caketetu/SPM-STMTB-SLED/SPM-STMTB-V1_SLED-Shield.kicad_pcb

## KiCad design SPM-STMTB-V1_SLED-Shield.kicad_pcb (2026-10-27)

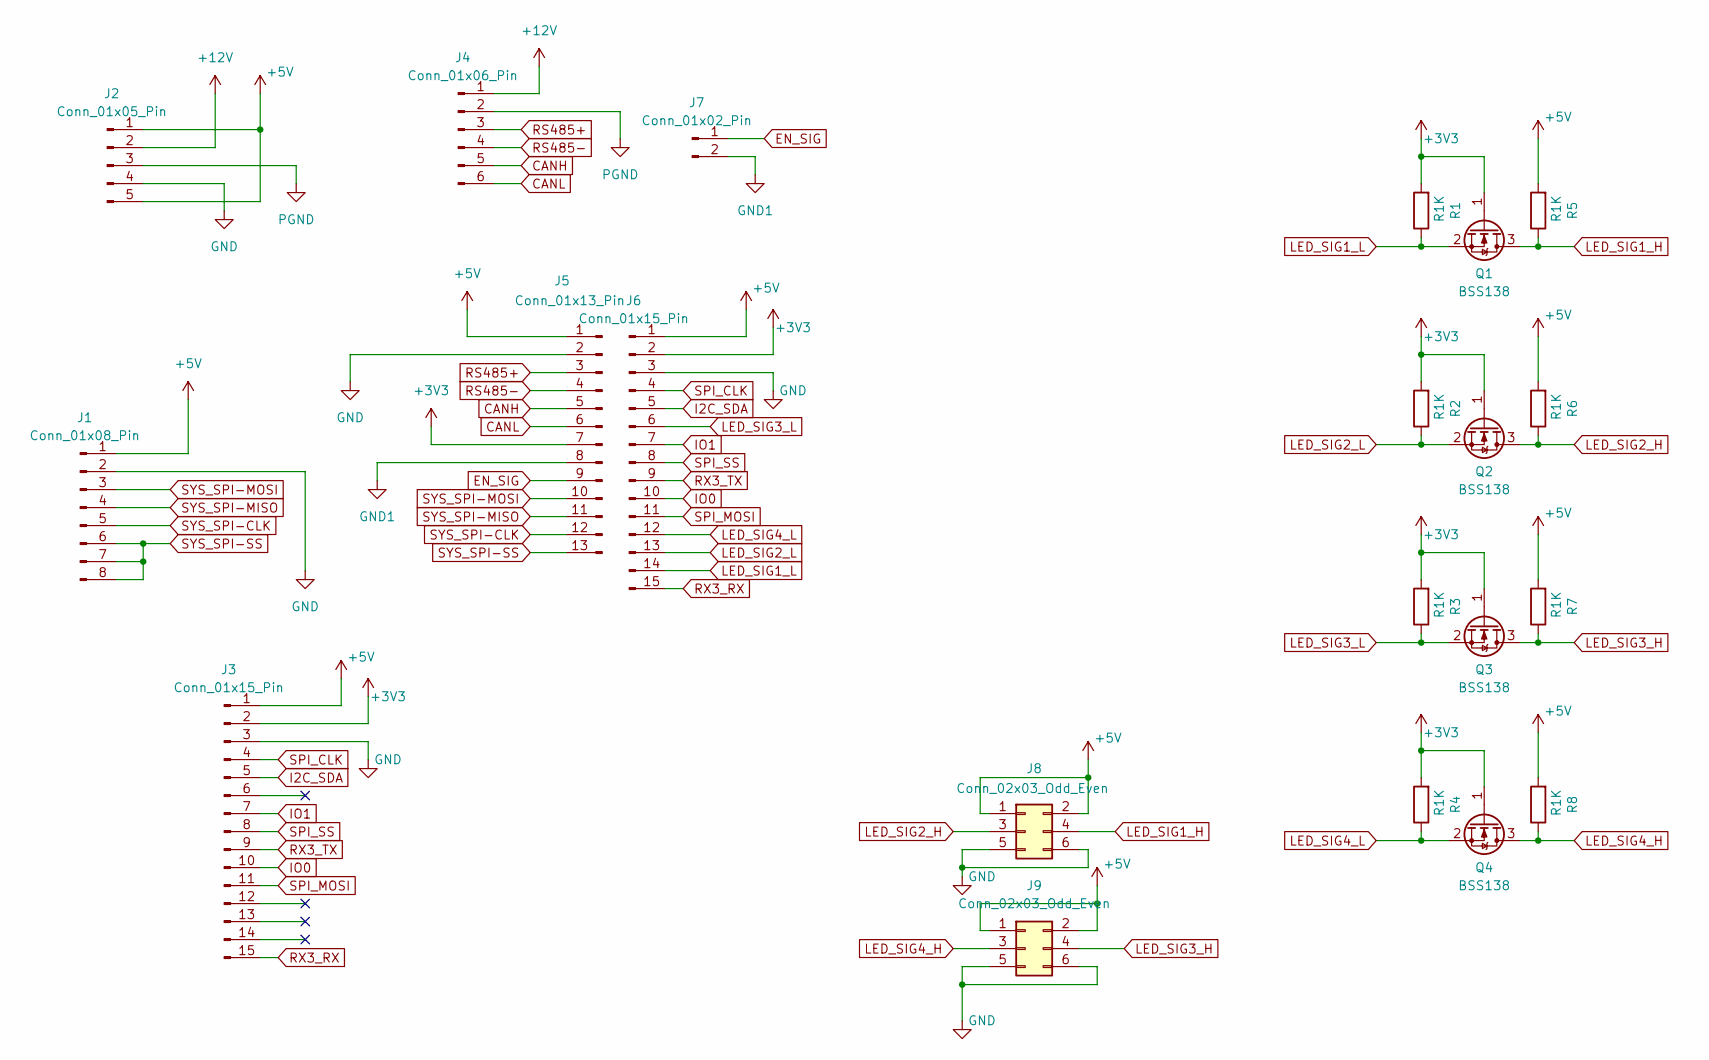
[picture p1: schematic SPM-STMTB-V1_SLED-Shield.kicad_sch]

Parts:
J1: Conn_01x08_Pin; PinSocket_1x08_P2.54mm_Vertical
J2: Conn_01x05_Pin; PinSocket_1x05_P2.54mm_Vertical
J3, J6: Conn_01x15_Pin; PinSocket_1x15_P2.54mm_Vertical
J4: Conn_01x06_Pin; PinHeader_1x06_P2.54mm_Vertical
J5: Conn_01x13_Pin; PinSocket_1x13_P2.54mm_Vertical
J7: Conn_01x02_Pin; PinSocket_1x02_P2.54mm_Vertical
J8, J9: Conn_02x03_Odd_Even; PinHeader_2x03_P2.54mm_Horizontal
Q1, Q2, Q3, Q4: BSS138; SOT-23
R1, R2, R3, R4, R5, R6, R7, R8: R1K; R_0603_1608Metric

Connections:
+3V3: J3.2, J5.7, J6.2, Q1.1 (G), Q2.1 (G), Q3.1 (G), Q4.1 (G), R1.2, R2.2, R3.2, R4.2
+5V: J1.1, J2.1, J2.5, J3.1, J5.1, J6.1, J8.1, J8.2, J9.1, J9.2, R5.2, R6.2, R7.2, R8.2
+12V: J2.2, J4.1
CANH: J4.5, J5.5
CANL: J4.6, J5.6
EN_SIG: J5.9, J7.1
GND: J1.2, J2.4, J3.3, J5.2, J6.3, J8.5, J8.6, J9.5, J9.6
GND1: J5.8, J7.2
I2C_SDA: J3.5, J6.5
IO0: J3.10, J6.10
IO1: J3.7, J6.7
LED_SIG1_H: J8.4, Q1.3 (D), R5.1
LED_SIG1_L: J6.14, Q1.2 (S), R1.1
LED_SIG2_H: J8.3, Q2.3 (D), R6.1
LED_SIG2_L: J6.13, Q2.2 (S), R2.1
LED_SIG3_H: J9.4, Q3.3 (D), R7.1
LED_SIG3_L: J6.6, Q3.2 (S), R3.1
LED_SIG4_H: J9.3, Q4.3 (D), R8.1
LED_SIG4_L: J6.12, Q4.2 (S), R4.1
PGND: J2.3, J4.2
RS485+: J4.3, J5.3
RS485-: J4.4, J5.4
RX3_RX: J3.15, J6.15
RX3_TX: J3.9, J6.9
SPI_CLK: J3.4, J6.4
SPI_MOSI: J3.11, J6.11
SPI_SS: J3.8, J6.8
SYS_SPI-CLK: J1.5, J5.12
SYS_SPI-MISO: J1.4, J5.11
SYS_SPI-MOSI: J1.3, J5.10
SYS_SPI-SS: J1.6, J1.7, J1.8, J5.13

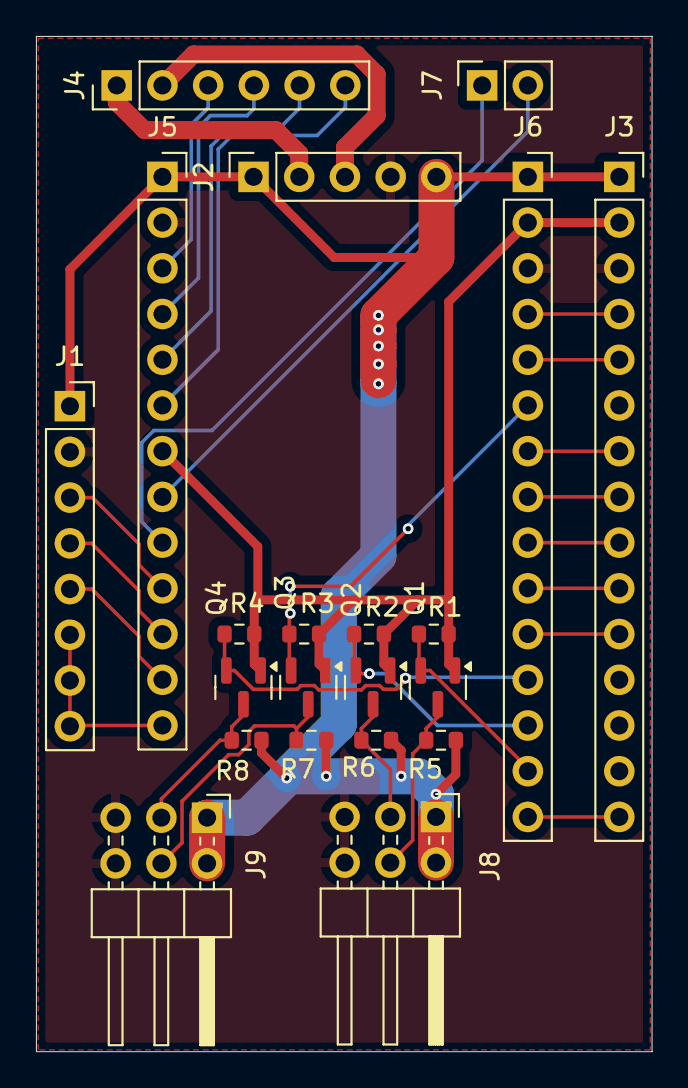
[picture p2: board SPM-STMTB-V1_SLED-Shield.kicad_pcb from above]

Board: 2 copper layers, 34.2 x 56.4 mm, 21 parts (0 on the bottom side), 31 nets.
