caketetu/SPM-STMTB-SLED/Core/Src/SPM_Modbus.c

/*
 * Mymodbus.cpp
 *
 *  Created on: Sep 16, 2025
 *      Author: t-fukumoto
 */

#include "SPM_Modbus.h"

#ifdef PLATFORM_ESP32
	String params = "/params.txt";
#endif
uint8_t p_data[HOLDING_REGS_MAX*2];

uint8_t modbus_id;
int16_t *p_input_regs[INPUT_REGS_MAX];
uint8_t *p_coils[COILS_MAX/8];
int16_t *p_holding_regs[HOLDING_REGS_MAX];
sCycFunc cycfunc0;
sCycFunc cycfunc1;
sCycFunc cycfunc2;
sCycFunc cycfunc3;
sCycFunc cycfunc4;
int16_t dummy16=0;	//ダミーのアドレス16bit
uint8_t dummy8=0;	//ダミーのアドレス8bit

// buf		受信データ
// length	受信データ長(CRCを除く)
uint16_t calc_crc(uint8_t *buf, int length) {
  uint16_t crc = 0xFFFF;
  int i, j;
  uint8_t carrayFlag;
  for (i = 0; i < length; i++) {
    crc ^= buf[i];
    for (j = 0; j < 8; j++) {
      carrayFlag = crc & 1;
      crc = crc >> 1;
      if (carrayFlag) {
        crc ^= 0xA001;
      }
    }
  }
  return crc;
}

uint16_t convert_uint16(uint8_t h_data, uint8_t l_data) {
  uint16_t conv_data = (uint16_t)(h_data << 8) + l_data;
  return conv_data;
}

int16_t convert_int16(uint8_t h_data, uint8_t l_data) {
  int16_t conv_data = (int16_t)(h_data << 8) + l_data;
  return conv_data;
}

//パラメータセーブ
#ifdef PLATFORM_ESP32
int param_save(fs::FS &fs)
{
  fs.remove(params);

  File file = fs.open(params,"w");
  if( file ){
    for(int i=0; i<HOLDING_REGS_MAX*2; i+=2){
      p_data[i] = (uint8_t)(*p_holding_regs[i/2] >> 8);
      p_data[i+1] = *p_holding_regs[i/2];
    }

    file.write((uint8_t*)p_data, sizeof(p_data));
    file.close();
    return 1;
  }
  else{
    return 0;
  }
}

//パラメータロード
int param_load(fs::FS &fs)
{
  File file = fs.open(params,"r"); //データを読み込む

  if(file){ //ファイルを開いて以下を処理
    file.read((uint8_t*)p_data, sizeof(p_data));
    file.close(); //ファイルを閉じる
    Serial.println("param load");
    for(int i=0; i<HOLDING_REGS_MAX*2; i+=2){
      *p_holding_regs[i/2] = convert_int16(p_data[i], p_data[i+1]);
    }
    return 1;
  }
  else{ //ファイルが開けなかった場合
    return 0;
  }
}
#endif

//パラメータセーブ
#ifdef PLATFORM_STM32
uint32_t FlashEraseData(){
	HAL_FLASH_Unlock();
	FLASH_EraseInitTypeDef erase;
	erase.TypeErase=FLASH_TYPEERASE_PAGES;
	erase.PageAddress = 0x800F000;
	erase.NbPages=1;

	uint32_t error=0;
	HAL_FLASHEx_Erase(&erase, &error);

	HAL_FLASH_Lock();
	return error;

}
int ParamSave()
{
	uint32_t start_addr=0x800F000;

	FlashEraseData();
	HAL_FLASH_Unlock();
	for(int i=0; i<HOLDING_REGS_MAX; i++){
		int16_t fdata=*p_holding_regs[i];
		HAL_FLASH_Program(FLASH_TYPEPROGRAM_HALFWORD, start_addr+(i*2),fdata);
	}
	HAL_FLASH_Lock();

	return 1;
}
//パラメータロード
int ParamLoad()
{
	uint32_t* p = 0x800F000;
	uint32_t start_addr=0x800F000;//0x0807F800;

	uint8_t flash_data[HOLDING_REGS_MAX*2];
	memcpy(flash_data,(uint32_t*)start_addr,HOLDING_REGS_MAX*2);

//    for(int i=0; i<HOLDING_REGS_MAX*2; i++){
//    	uint8_t* adr = start_addr+i;
//    	flash_data[i] = *adr;
//    }

    for(int i=0; i<HOLDING_REGS_MAX*2; i+=2){
      *p_holding_regs[i/2] = convert_int16(flash_data[i+1], flash_data[i]);
    }
    return 1;
}
#endif

//パラメータセーブ
#ifdef PLATFORM_STM32C0
#define PARAM_FLASH_ADDR    0x0801F800U
#define FLASH_PAGE_SIZE_C0  0x800U       // 2048 bytes
/*
 * STM32C092KBT6
 * Flash = 128KB
 * Flash start = 0x08000000
 * Last page   = 0x0801F800 ～ 0x0801FFFF
 *
 * 0x0801F800 = page 63
 */
#define PARAM_FLASH_PAGE    63U
//====================================================
// Flash消去
//====================================================
uint32_t FlashEraseData(void)
{
    FLASH_EraseInitTypeDef erase = {0};
    uint32_t page_error = 0;

    if (HAL_FLASH_Unlock() != HAL_OK)
    {
        return 1;
    }

    erase.TypeErase = FLASH_TYPEERASE_PAGES;
    erase.Page      = PARAM_FLASH_PAGE;
    erase.NbPages   = 1;

    HAL_StatusTypeDef status = HAL_FLASHEx_Erase(&erase, &page_error);

    HAL_FLASH_Lock();

    if (status != HAL_OK)
    {
        return page_error;
    }

    return 0;
}

//====================================================
// パラメータ保存
//====================================================
int ParamSave(void)
{
    FlashEraseData();

    HAL_FLASH_Unlock();

    for (uint32_t i = 0; i < HOLDING_REGS_MAX; i += 4)
    {
        uint64_t data =
              ((uint64_t)(uint16_t)(*p_holding_regs[i + 0]))
            | ((uint64_t)(uint16_t)(*p_holding_regs[i + 1]) << 16)
            | ((uint64_t)(uint16_t)(*p_holding_regs[i + 2]) << 32)
            | ((uint64_t)(uint16_t)(*p_holding_regs[i + 3]) << 48);

        HAL_FLASH_Program(
            FLASH_TYPEPROGRAM_DOUBLEWORD,
            PARAM_FLASH_ADDR + (i / 4) * 8,
            data
        );
    }

    HAL_FLASH_Lock();

    return 1;
}

//====================================================
// パラメータロード
//====================================================
int ParamLoad(void)
{
    for (uint32_t i = 0; i < HOLDING_REGS_MAX; i += 4)
    {
        uint64_t data =
            *(volatile uint64_t *)
            (PARAM_FLASH_ADDR + (i / 4) * 8);

        *p_holding_regs[i + 0] = (int16_t)( data        & 0xFFFF);
        *p_holding_regs[i + 1] = (int16_t)((data >> 16) & 0xFFFF);
        *p_holding_regs[i + 2] = (int16_t)((data >> 32) & 0xFFFF);
        *p_holding_regs[i + 3] = (int16_t)((data >> 48) & 0xFFFF);
    }

    return 1;
}
#endif

void make_exception_resp(uint8_t *buf, uint8_t id, uint8_t fc, uint8_t ec) {
  buf[0] = id;
  buf[1] = fc | 0x80;
  buf[2] = ec;
  uint16_t crc = calc_crc(buf, 3);
  buf[4] = crc;
  buf[5] = (uint8_t)(crc >> 8);
  return;
}

void SPM_ModbusInit(void) {
	for(int i=0; i<COILS_MAX/8;i++)
	{
		p_coils[i] = &dummy8;
	}
	for(int i=0; i<INPUT_REGS_MAX;i++)
	{
		p_input_regs[i] = &dummy16;
	}
	for(int i=0; i<HOLDING_REGS_MAX;i++)
	{
		p_holding_regs[i] = &dummy16;
	}

	cycfunc0.rx_len=0;
	cycfunc0.tx_len=0;
	for(int i=0; i<8;i++)
	{
		cycfunc0.rx_adr[i] = &dummy16;
		cycfunc0.tx_adr[i] = &dummy16;
	}

	cycfunc1.rx_len=0;
	cycfunc1.tx_len=0;
	for(int i=0; i<8;i++)
	{
		cycfunc1.rx_adr[i] = &dummy16;
		cycfunc1.tx_adr[i] = &dummy16;
	}

	cycfunc2.rx_len=0;
	cycfunc2.tx_len=0;
	for(int i=0; i<8;i++)
	{
		cycfunc2.rx_adr[i] = &dummy16;
		cycfunc2.tx_adr[i] = &dummy16;
	}

	cycfunc3.rx_len=0;
	cycfunc3.tx_len=0;
	for(int i=0; i<8;i++)
	{
		cycfunc3.rx_adr[i] = &dummy16;
		cycfunc3.tx_adr[i] = &dummy16;
	}

	cycfunc4.rx_len=0;
	cycfunc4.tx_len=0;
	for(int i=0; i<8;i++)
	{
		cycfunc4.rx_adr[i] = &dummy16;
		cycfunc4.tx_adr[i] = &dummy16;
	}
}

void SPM_ModbusSetAddress(uint8_t dev_id) {
	modbus_id = dev_id;
}

/*int SPM_ModbusParamLoad(void) {
#ifdef PLATFORM_ESP32
  if (!SPIFFS.begin(FORMAT_SPIFFS_IF_FAILED)) {
    Serial.println("SPIFFS Mount Failed");
    while(1);
  }
  return param_load(SPIFFS);
#endif
}*/

int SPM_ModbusTask(uint8_t *rbuf, int rl, uint8_t *sbuf) {
  if (rbuf[0] == modbus_id) {
    uint16_t crc_check = convert_uint16(rbuf[rl - 1], rbuf[rl - 2]);
    if (crc_check == calc_crc(rbuf, rl - 2)) {
      switch (rbuf[1]) {
          //保持ステータス読み出し
          //パラメータなどを読み出す
          // Read Holding Register（03）
        case 3:
          {
            uint16_t adr = convert_uint16(rbuf[2], rbuf[3]);
            uint16_t data_len = convert_uint16(rbuf[4], rbuf[5]);
            //レジスタ不正エラー
            if (adr + data_len > HOLDING_REGS_MAX) {
              make_exception_resp(sbuf, modbus_id, rbuf[1], INVAILED_ADR);
              return 5;
            }
            int sbuf_len = 0;
            sbuf[0] = modbus_id;
            sbuf[1] = rbuf[1];
            sbuf[2] = data_len * 2;
            sbuf_len = 3;
            for (int i = adr; i < adr + data_len; i++) {
              sbuf[sbuf_len++] = (uint8_t)(*p_holding_regs[i] >> 8);
              sbuf[sbuf_len++] = *p_holding_regs[i];
            }

            uint16_t crc = calc_crc(sbuf, sbuf_len);
            sbuf[sbuf_len++] = crc;
            sbuf[sbuf_len++] = (uint8_t)(crc >> 8);
            return sbuf_len;
          }
          break;

          //入力ステータス読み出し
          //システムステータスや変数などを読み出す
          // Read Input Register（04）
        case 4:
          {
            uint16_t adr = convert_uint16(rbuf[2], rbuf[3]);
            uint16_t data_len = convert_uint16(rbuf[4], rbuf[5]);
            //レジスタ不正エラー
            if (adr + data_len > INPUT_REGS_MAX) {
              make_exception_resp(sbuf, modbus_id, rbuf[1], INVAILED_ADR);
              return 5;
            }
            int sbuf_len = 0;
            sbuf[0] = modbus_id;
            sbuf[1] = rbuf[1];
            sbuf[2] = data_len * 2;
            sbuf_len = 3;
            for (int i = adr; i < adr + data_len; i++) {
              sbuf[sbuf_len++] = (uint8_t)(*p_input_regs[i] >> 8);
              sbuf[sbuf_len++] = *p_input_regs[i];
            }

            uint16_t crc = calc_crc(sbuf, sbuf_len);
            sbuf[sbuf_len++] = crc;
            sbuf[sbuf_len++] = (uint8_t)(crc >> 8);
            return sbuf_len;
          }
          break;

          //単一コイルに書き込む
          //イネーブルやモードの変更、パラメータの保存フラグなど
          // Force Single Coil（05）
        case 5:
          {
            uint16_t adr = convert_uint16(rbuf[2], rbuf[3]);
            uint16_t value = convert_uint16(rbuf[4], rbuf[5]);
            int index = adr / 8;
            int coils_value = 0x01 << (adr % 8);

            //レジスタ不正エラー
            if (adr > COILS_MAX * 16) {
              make_exception_resp(sbuf, modbus_id, rbuf[1], INVAILED_ADR);
              return 5;
            }

            //レジスタ書き換え
            if (value == 0xFF00) {
              *p_coils[index] = *p_coils[index] | coils_value;
            } else if (value == 0x0000) {
              *p_coils[index] = *p_coils[index] & ~coils_value;
            } else {
              //データ不正エラー
              make_exception_resp(sbuf, modbus_id, rbuf[1], INVAILED_DATA);
              return 5;
            }
            sbuf[0] = modbus_id;
            sbuf[1] = rbuf[1];
            sbuf[2] = rbuf[2];
            sbuf[3] = rbuf[3];
            sbuf[4] = rbuf[4];
            sbuf[5] = rbuf[5];
            uint16_t crc = calc_crc(sbuf, 6);
            sbuf[6] = crc;
            sbuf[7] = (uint8_t)(crc >> 8);
            return 8;
          }
          break;

          //保持レジスタ書き込み
          //単一の保持レジスタの内容を書き換えます
          // Preset Single Register（06)
        case 6:
          {
            uint16_t adr = convert_uint16(rbuf[2], rbuf[3]);
            //レジスタ不正エラー
            if (adr > HOLDING_REGS_MAX) {
              make_exception_resp(sbuf, modbus_id, rbuf[1], INVAILED_ADR);
              return 5;
            }
            *p_holding_regs[adr] = convert_int16(rbuf[4], rbuf[5]);
            sbuf[0] = modbus_id;
            sbuf[1] = rbuf[1];
            sbuf[2] = rbuf[2];
            sbuf[3] = rbuf[3];
            sbuf[4] = rbuf[4];
            sbuf[5] = rbuf[5];
            uint16_t crc = calc_crc(sbuf, 6);
            sbuf[6] = crc;
            sbuf[7] = (uint8_t)(crc >> 8);
            return 8;
          }
          break;

          //保持レジスタ書き込み
          //複数の連続した保持レジスタ領域へ書き込みます。
          // Preset Multiple Registers（16，0x10）
        case 16:
          {
            uint16_t adr = convert_uint16(rbuf[2], rbuf[3]);
            uint16_t data_len = convert_uint16(rbuf[4], rbuf[5]);
            uint16_t n_byte = rbuf[6];
            //レジスタ不正エラー
            if (adr + data_len > HOLDING_REGS_MAX) {
              make_exception_resp(sbuf, modbus_id, rbuf[1], INVAILED_ADR);
              return 5;
            }

            for (int i = 7; i < n_byte + 7; i += 2) {
              *p_holding_regs[adr++] = convert_int16(rbuf[i], rbuf[i + 1]);
            }
            sbuf[0] = modbus_id;
            sbuf[1] = rbuf[1];
            sbuf[2] = rbuf[2];
            sbuf[3] = rbuf[3];
            sbuf[4] = rbuf[4];
            sbuf[5] = rbuf[5];
            uint16_t crc = calc_crc(sbuf, 6);
            sbuf[6] = crc;
            sbuf[7] = (uint8_t)(crc >> 8);
            return 8;
          }
          break;

        //ここから独自ファンクションコード。
        //Cyclic Function 0(65)
        case 65:
          {
            sCycFunc cf = cycfunc0;
            int rc = 2;
            for (int i = 0; i < cf.tx_len; i++) {
              *cf.tx_adr[i] = convert_int16(rbuf[rc++], rbuf[rc++]);
            }

            rc = 0;
            sbuf[rc++] = modbus_id;
            sbuf[rc++] = rbuf[1];
            for (int i = 0; i < cf.rx_len; i++) {
              sbuf[rc++] = (uint8_t)(*cf.rx_adr[i] >> 8);
              sbuf[rc++] = *cf.rx_adr[i];
            }
            uint16_t crc = calc_crc(sbuf, rc);
            sbuf[rc++] = crc;
            sbuf[rc++] = (uint8_t)(crc >> 8);
            return rc;
          }

        //Cyclic Function 1(66)
        case 66:
          {
            sCycFunc cf = cycfunc1;
            int rc = 2;
            for (int i = 0; i < cf.tx_len; i++) {
              *cf.tx_adr[i] = convert_int16(rbuf[rc++], rbuf[rc++]);
            }

            rc = 0;
            sbuf[rc++] = modbus_id;
            sbuf[rc++] = rbuf[1];
            for (int i = 0; i < cf.rx_len; i++) {
              sbuf[rc++] = (uint8_t)(*cf.rx_adr[i] >> 8);
              sbuf[rc++] = *cf.rx_adr[i];
            }
            uint16_t crc = calc_crc(sbuf, rc);
            sbuf[rc++] = crc;
            sbuf[rc++] = (uint8_t)(crc >> 8);
            return rc;
          }

        //Cyclic Function 2(67)
        case 67:
          {
            sCycFunc cf = cycfunc2;
            int rc = 2;
            for (int i = 0; i < cf.tx_len; i++) {
              *cf.tx_adr[i] = convert_int16(rbuf[rc++], rbuf[rc++]);
            }

            rc = 0;
            sbuf[rc++] = modbus_id;
            sbuf[rc++] = rbuf[1];
            for (int i = 0; i < cf.rx_len; i++) {
              sbuf[rc++] = (uint8_t)(*cf.rx_adr[i] >> 8);
              sbuf[rc++] = *cf.rx_adr[i];
            }
            uint16_t crc = calc_crc(sbuf, rc);
            sbuf[rc++] = crc;
            sbuf[rc++] = (uint8_t)(crc >> 8);
            return rc;
          }

        //Cyclic Function 3(68)
        case 68:
          {
            sCycFunc cf = cycfunc3;
            int rc = 2;
            for (int i = 0; i < cf.tx_len; i++) {
              *cf.tx_adr[i] = convert_int16(rbuf[rc++], rbuf[rc++]);
            }

            rc = 0;
            sbuf[rc++] = modbus_id;
            sbuf[rc++] = rbuf[1];
            for (int i = 0; i < cf.rx_len; i++) {
              sbuf[rc++] = (uint8_t)(*cf.rx_adr[i] >> 8);
              sbuf[rc++] = *cf.rx_adr[i];
            }
            uint16_t crc = calc_crc(sbuf, rc);
            sbuf[rc++] = crc;
            sbuf[rc++] = (uint8_t)(crc >> 8);
            return rc;
          }

        //Cyclic Function 4(69)
        case 69:
          {
            sCycFunc cf = cycfunc4;
            int rc = 2;
            for (int i = 0; i < cf.tx_len; i++) {
              *cf.tx_adr[i] = convert_int16(rbuf[rc++], rbuf[rc++]);
            }

            rc = 0;
            sbuf[rc++] = modbus_id;
            sbuf[rc++] = rbuf[1];
            for (int i = 0; i < cf.rx_len; i++) {
              sbuf[rc++] = (uint8_t)(*cf.rx_adr[i] >> 8);
              sbuf[rc++] = *cf.rx_adr[i];
            }
            uint16_t crc = calc_crc(sbuf, rc);
            sbuf[rc++] = crc;
            sbuf[rc++] = (uint8_t)(crc >> 8);
            return rc;
          }

        //パラメータセーブ
        case 75:
          {
            int rc=0;
            sbuf[rc++] = modbus_id;
            sbuf[rc++] = rbuf[1];
#ifdef PLATFORM_ESP32
            if(ParamSave(SPIFFS)){
              sbuf[rc++] = 0;
              sbuf[rc++] = 1;
              uint16_t crc = calc_crc(sbuf, rc);
              sbuf[rc++] = crc;
              sbuf[rc++] = (uint8_t)(crc >> 8);
            }else{
              sbuf[rc++] = 0;
              sbuf[rc++] = 0;
              uint16_t crc = calc_crc(sbuf, rc);
              sbuf[rc++] = crc;
              sbuf[rc++] = (uint8_t)(crc >> 8);
            }
#endif
#ifdef PLATFORM_STM32
            if(ParamSave()){
              sbuf[rc++] = 0;
              sbuf[rc++] = 1;
              uint16_t crc = calc_crc(sbuf, rc);
              sbuf[rc++] = crc;
              sbuf[rc++] = (uint8_t)(crc >> 8);
            }else{
              sbuf[rc++] = 0;
              sbuf[rc++] = 0;
              uint16_t crc = calc_crc(sbuf, rc);
              sbuf[rc++] = crc;
              sbuf[rc++] = (uint8_t)(crc >> 8);
            }
#endif
#ifdef PLATFORM_STM32C0
            if(ParamSave()){
              sbuf[rc++] = 0;
              sbuf[rc++] = 1;
              uint16_t crc = calc_crc(sbuf, rc);
              sbuf[rc++] = crc;
              sbuf[rc++] = (uint8_t)(crc >> 8);
            }else{
              sbuf[rc++] = 0;
              sbuf[rc++] = 0;
              uint16_t crc = calc_crc(sbuf, rc);
              sbuf[rc++] = crc;
              sbuf[rc++] = (uint8_t)(crc >> 8);
            }
#endif
            return rc;
          }

        //default UNKNOWN FUNCTIONエラー
        default:
          make_exception_resp(sbuf, modbus_id, rbuf[1], UNKOWN_FUNC);
          return 5;
          break;
      }
    } else {
      return 0;
    }
  } else {
    return 0;
  }
}
