caketetu/SPM-STMTB-SLED/firmware/STM32C092KBT6_test.ioc

Mcu.UserName=STM32C092KBTx
PA0.Signal=S_TIM1_CH1
PA1.Signal=S_TIM1_CH2
PA10.Signal=USART1_RX
PA13.Signal=DEBUG_SWDIO
PA14-BOOT0.Signal=DEBUG_SWCLK
PA15.Signal=USART2_RX
PA2.Signal=USART2_TX
PA3.Signal=S_TIM1_CH4
PA5.Signal=SPI1_SCK
PA6.Signal=SPI1_MISO
PA7.Signal=SPI1_MOSI
PA9.Signal=USART1_TX
PB0.Signal=SPI1_NSS
PB4.Signal=GPIO_Output
PB5.Signal=GPIO_Input
PB6.Signal=S_TIM1_CH3
PC14-OSCX_IN(PC14).Signal=RCC_OSCX_IN
PC15-OSCX_OUT(PC15).Signal=RCC_OSCX_OUT
PC6.Signal=GPIO_Output
PF2-NRST.Signal=RCC_MCO
