caketetu/SPM-STMTB-SLED/(commit log)

2026-09-25 README.md 追加
2026-10-27 KiCADデータを追加 ソースはfirmwareに移動
2026-10-28 USART1追加、USART2と同じ仕様 CubeMXの変更が影響ないようにした
